aaromalonline/ecometachip/public/simulations_schematics/output_stages(thick)-axeslabeled.png

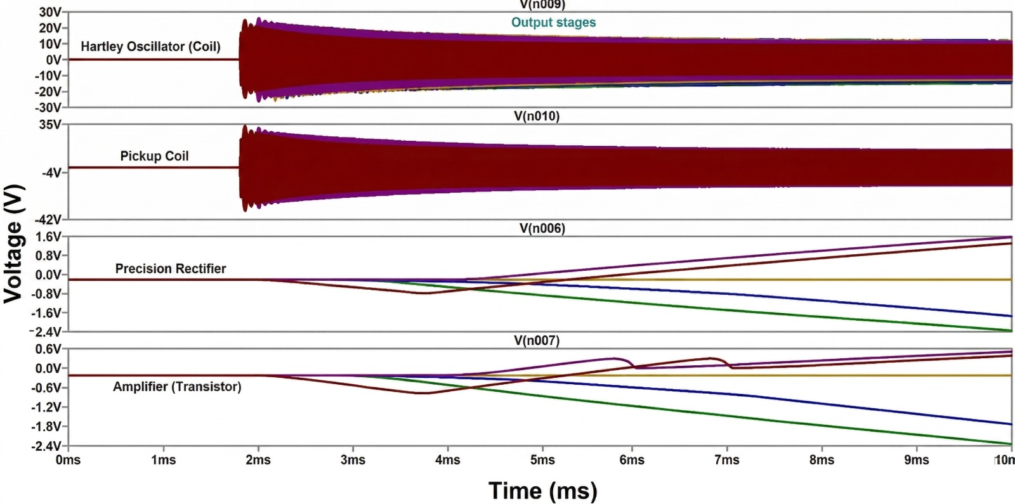
public/simulations_schematics/output_stages(thick)-axeslabeled.png
