aaromalonline/ecometachip/public/exp_setup/torroid-osc(oldckt).jpeg

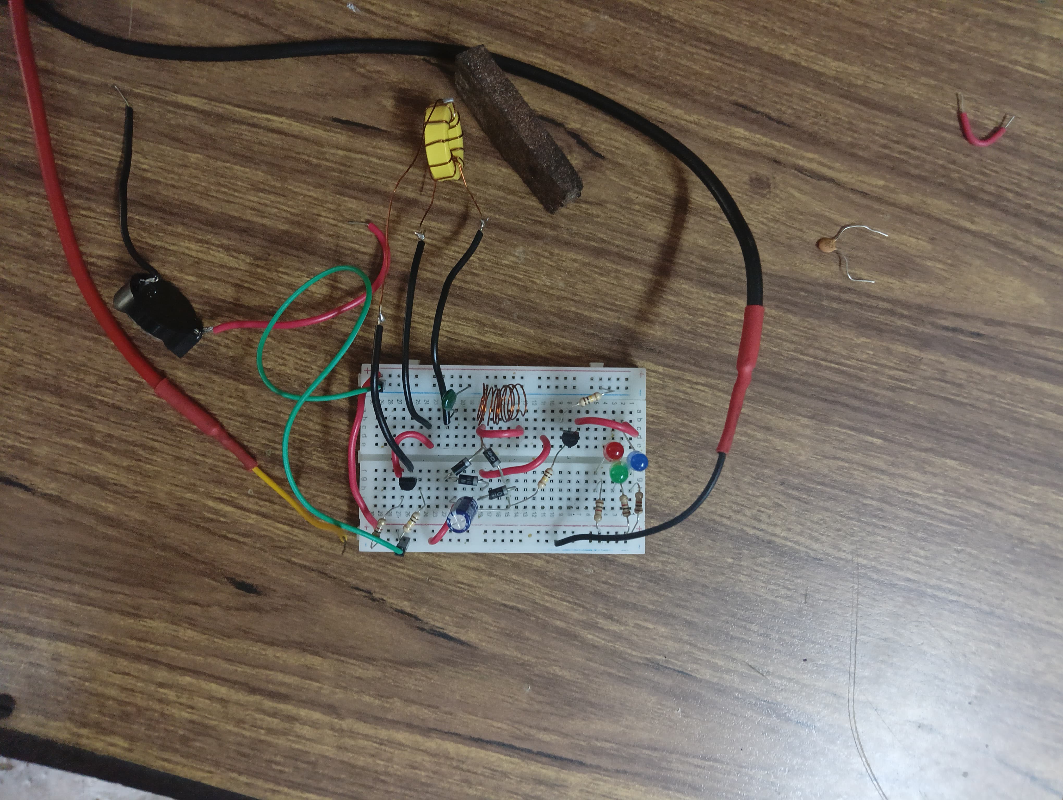
public/exp_setup/torroid-osc(oldckt).jpeg
