aaromalonline/ecometachip/papers/jpaper-main.tex

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

\begin{document}

% --- Title and Authors ---
\begin{center}
    {\Large\bfseries Ecometachip : A Low-Cost, Eco-Friendly Liquid Chemical Identifier Utilizing a Novel Coir-Rubber Substrate\par}
    \vspace{0.6cm}
    {\normalsize\bfseries Aaromal A, Abhiram B, Devanarayanan C.R, and Ivana Anto Kallookaran*\par}
    \vspace{0.4cm}
    {\small \textit{School of Engineering, Electronics \& Communication Engineering,\\ Cochin University of Science and Technology (CUSAT), Kochi, Kerala, India.}\par}
\end{center}
\vspace{0.6cm}

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

\section{Theoretical Framework and Mathematical Modeling}

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

\begin{figure}[H]
    \centering
    
    \caption{Scanning electron microscopy of (a) CoR and (b) CoRC substrates. The addition of carbon to the base CoR matrix creates the highly porous CoRC micro-structure utilized by the Eco-MetaChip for fluid integration. Image reproduced from Manohar et al. \cite{b1}.}
    \label{fig:sem_image}
\end{figure}

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

\vspace*{30pt}
\section{System Design and Hardware Architecture}

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

\begin{figure}[H]
    \centering
    
    \caption{Physical prototype of the EcometaChip. The image highlights the critical non-contact 2 mm air gap maintained between the hand-wound RF pickup coil and the highly porous Coir-Rubber Patch.}
    \label{fig:hardware_setup}
\end{figure}

\vspace*{6pt}
\subsection{Circuit Implementation and LTSpice Modeling}
Prior to physical deployment, the electronic architecture was mathematically modeled using LTspice. The Hartley oscillator utilizes a 47 pF NPO ceramic capacitor and a hand-wound 15-turn toroidal inductor ($54\text{ nH}$). 

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

\vspace*{12pt}
\section{Experimental Observations and Methodological Rigor}

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

plt.rcParams.update({'font.size': 15})

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

# 3. Perform Linear Regression
slope, intercept, r_value, p_value, std_err = stats.linregress(X, Y)

# 4. Create the Plot
plt.style.use('seaborn-v0_8-whitegrid')
plt.figure(figsize=(10, 7))

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

plt.text(45, 100, stats_text, fontsize=11, bbox=dict(facecolor='white', alpha=0.8, edgecolor='gray'))

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

\vspace*{14pt}
\section{Results and System Validation}

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

\newpage
As algorithmically executed and visually rendered by the Python analysis pipeline (Figure \ref{fig:sensitivity}), the system demonstrated a highly linear response. The calculated Sensitivity Fit was \textbf{2.31 mV/$\epsilon_r$} with an exceptional Coefficient of Determination (\textbf{$R^2$ Score}) of \textbf{0.906}. This provides definitive mathematical evidence that optimizing the CoRC carbon content successfully transitioned the material into a highly predictable, quantitative dielectric resonator.

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

\vspace*{6pt}
\subsection{Environmental Robustness and Repeatability}
For any field-deployable analytical instrument, immunity to environmental fluctuations is paramount. Utilizing the extensive dataset provided in Table \ref{tab:completelog}, the Python pipeline computed the baseline output drift across massive environmental swings.

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

\vspace*{6pt}
\subsection{Waveform Output and Hardware Visual Classification}
The current hardware prototype processes the pre-amplification DC output through a 2N3904 transistor to drive a simple multi-level LED interface. The distinct voltage separations achieved at the precision rectifier---and their respective trigger points for the final amplifier---were successfully simulated in LTspice (Figure \ref{fig:waveforms}) and perfectly align with the hardware behavior.

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

\newpage
In physical operation, the forward voltage drops ($V_f$) of parallel Red, Green, and Blue LEDs serve as an analog voltage discriminator:
\begin{itemize}
    \item A low-$\epsilon_r$ liquid like Petrol (yielding a mean of 72 mV) only weakly biases the base of the driver, dimly illuminating the \textbf{Red LED}.
    \item Ethanol ($\epsilon_r \approx 24$, yielding 184 mV) provides enough current gain to trigger both the \textbf{Red and Green LEDs}.
    \item Water, generating the maximum 262 mV baseline due to its massive $\epsilon_r \approx 80$, successfully triggers the highest-threshold \textbf{Blue LED} alongside Red and Green.
\end{itemize}

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

\newpage
\begin{thebibliography}{00}

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

\bibitem{b8} A. R. Von Hippel, \textit{Dielectrics and Waves}, Wiley, New York, 1954.

\end{thebibliography}

\end{document}
