aaromalonline/ecometachip/presentation/apscon26-prs.pdf

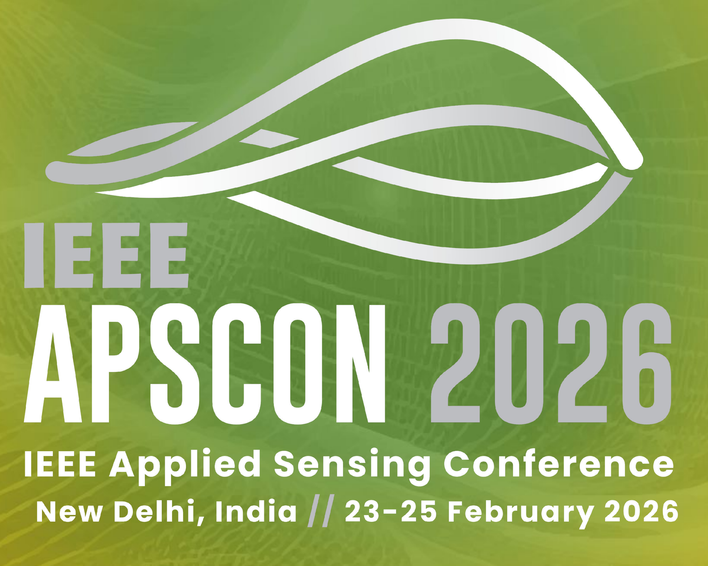
[picture p3: figure]

# Ecometachip-Mini

A Low-Cost, Eco-Friendly Chemical Identifier Utilizing a Novel Coir-Rubber Dielectric Sensor

# Abstract

This paper presents the Eco-MetaChip Mini, a novel, low-cost, and eco-friendly system for the preliminary identification of common liquids based on changes in their relative permittivity (ϵr) using a novel rubber coir material.

Authors : Abhiram B, Aaromal A, Devanarayanan CR, Ivana Anto

Affiliation : School of Engineering, CUSAT (Kerala, India)

# The problem

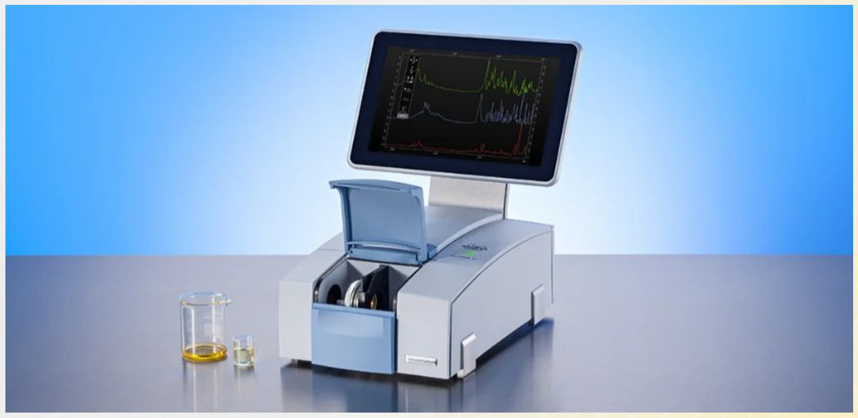
[picture p4: figure]

Need for low-cost, biodegradable sensing for field analysis

Benchtop FT-IR Spectrometers (current)

# Materials Required

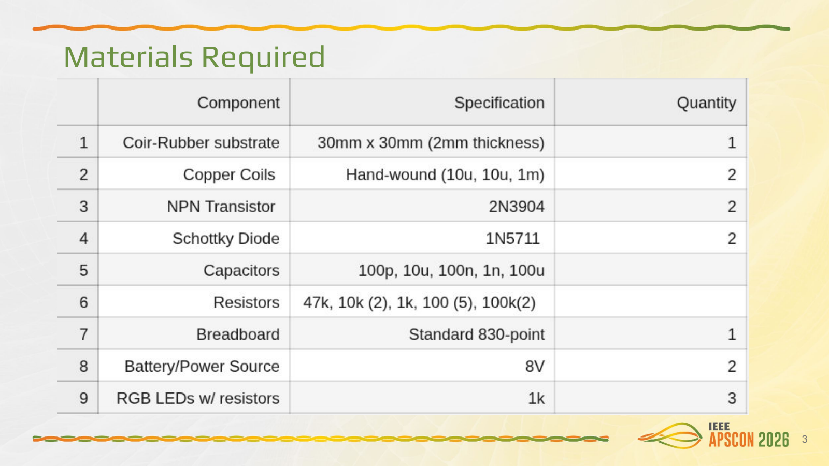
[picture p5: page 4]

# System Architecture

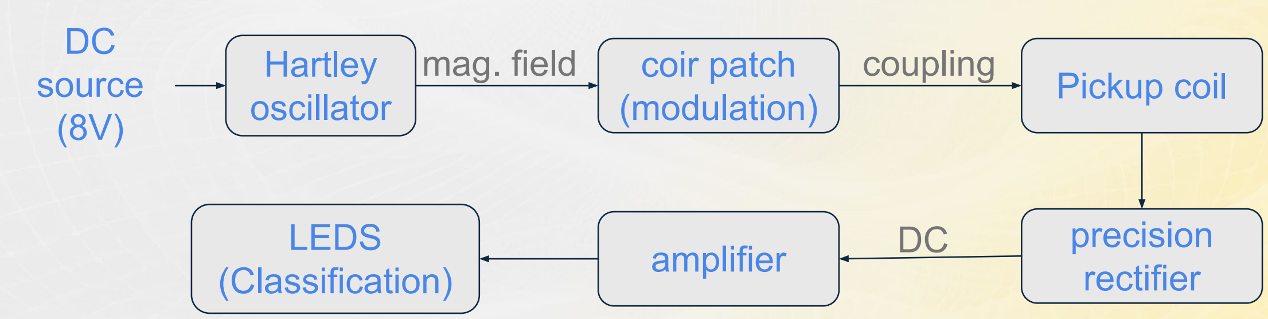
[picture p6: figure]
Hartley oscillator; coir patch; (modulation); Pickup coil; LEDS (Classification); mag. field; coupling; DC source (8V); precision; rectifier amplifier

100 MHz Hartley Oscillator coupled with dielectric resonator

# The Novel Material (Sensing Element)

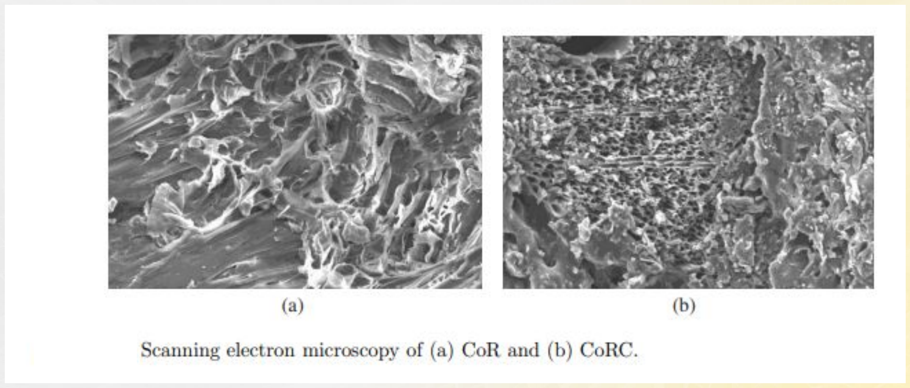
[picture p7: figure]

Coir-Rubber Composite: Porous matrix allows liquid integration

# Methodology/Physics (Dielectric Loading)

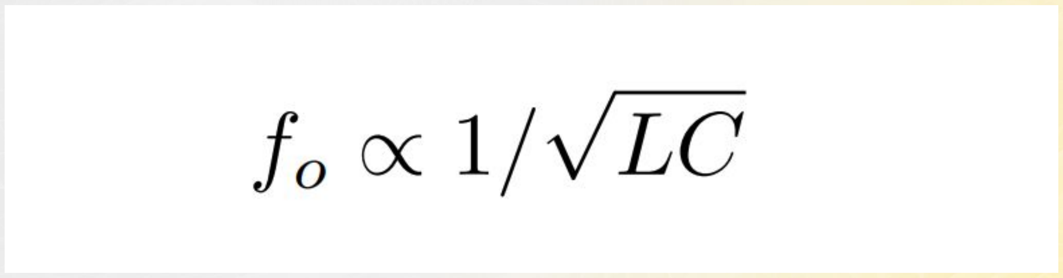
[picture p8: figure]

Liquid permittivity alters capacitance, modulating magnetic field amplitude

# Addressing Signal Loss

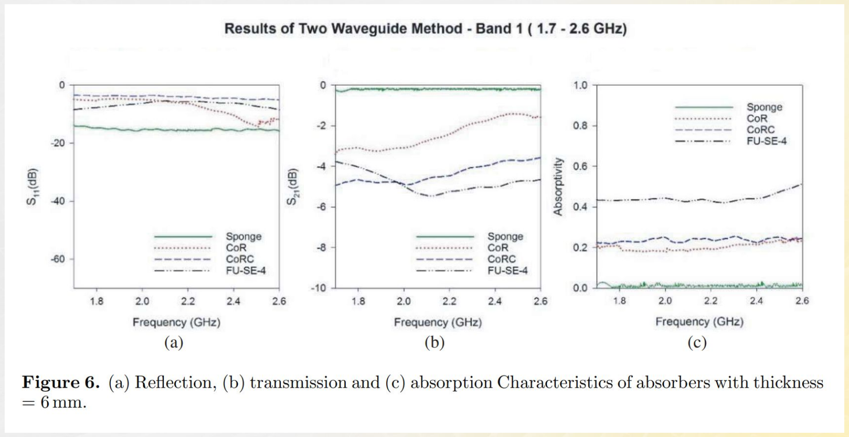
[picture p9: figure]

Carbon content optimized for coupling, not just absorption (εr of rubber-coir substrate with liquid ∝ coupling factor)

# Circuit Implementation

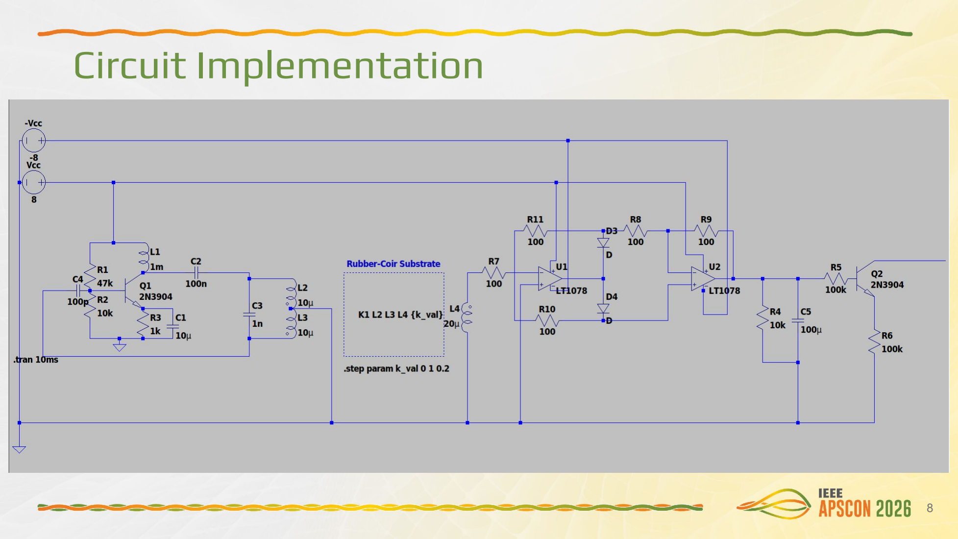
[picture p10: page 9]

## Simulation Results (Coupling)

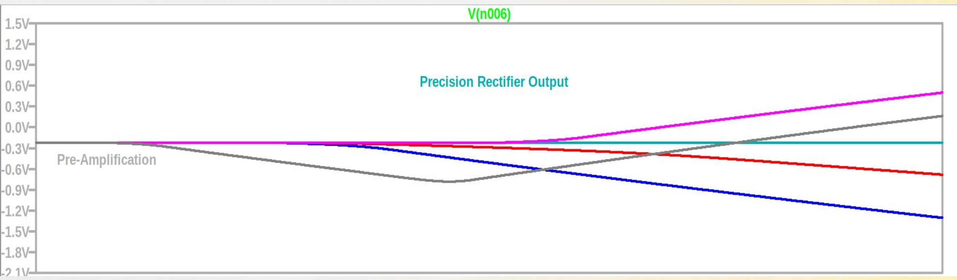
[picture p11: figure]

For increasing k_values btw coils 0, 0.2, 0.4, 0.6 (εr of rubber-coir substrate with liquid ∝ coupling factor k)

# Experimental Observations

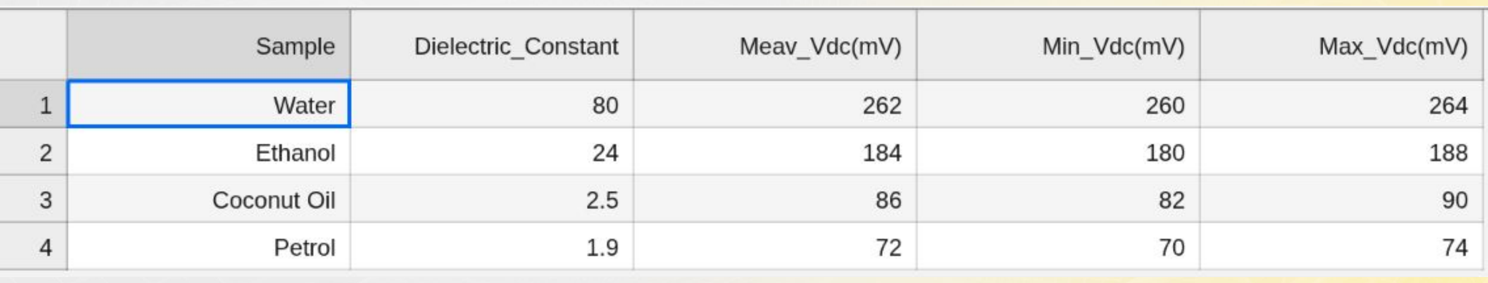
[picture p12: figure]

Higher permittivity liquids generate significantly higher output voltages.

## Repeatability

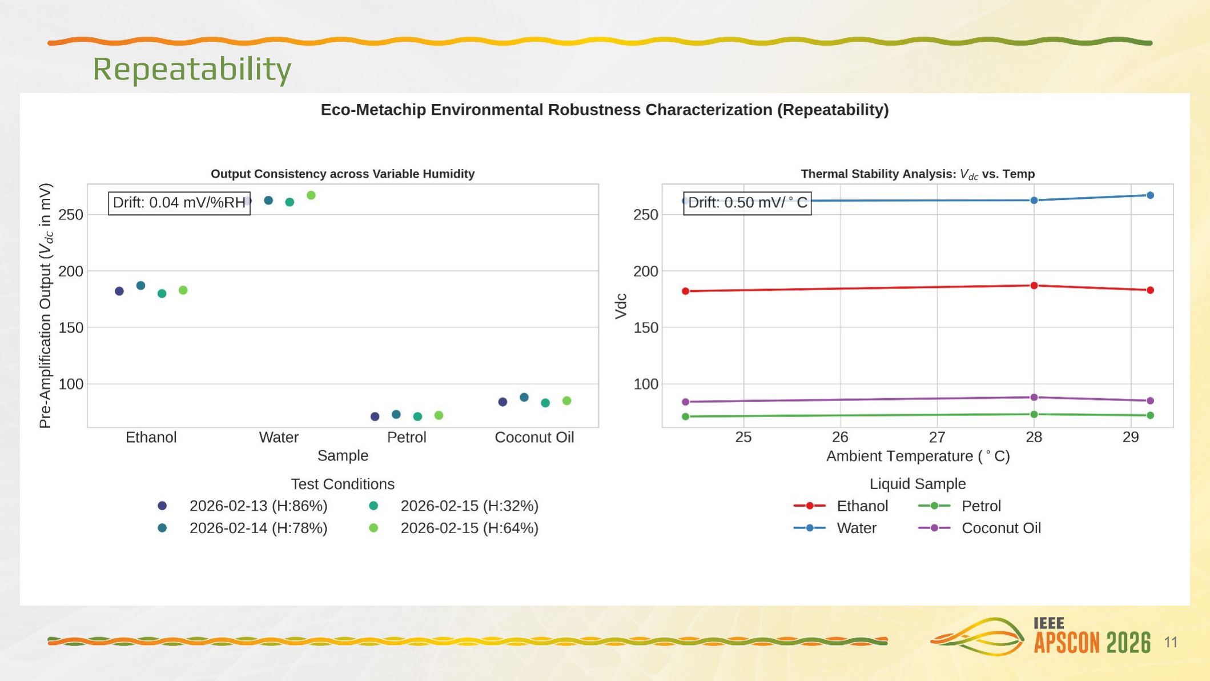
[picture p13: page 12]

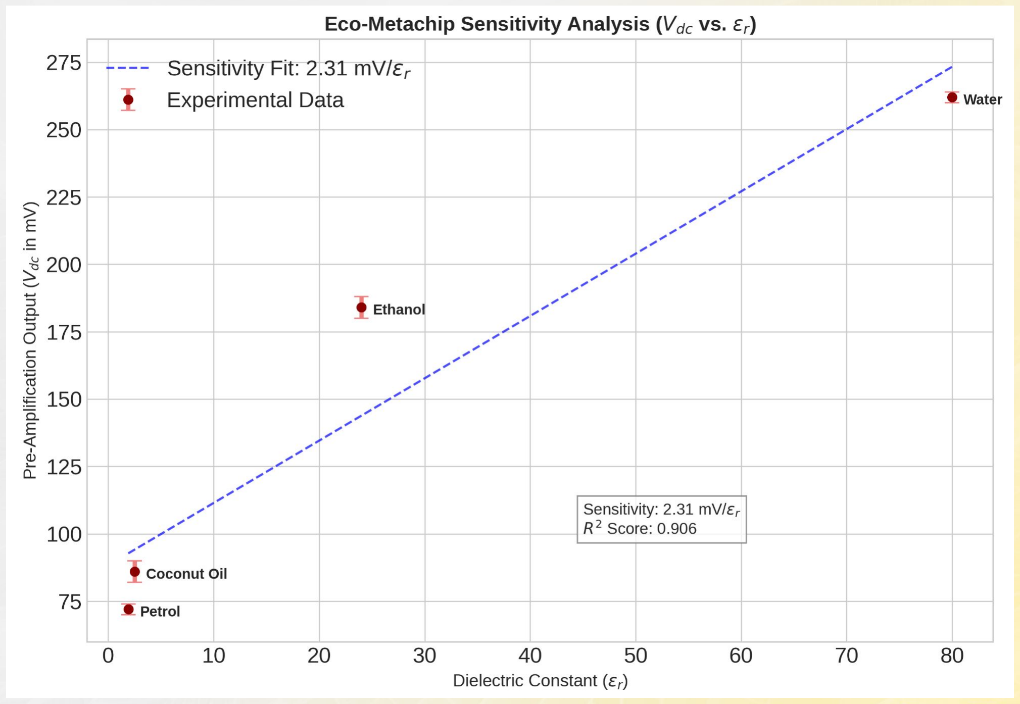
[picture p14: figure]

## Sensitivity

## Exp-Setup & Visual Classification

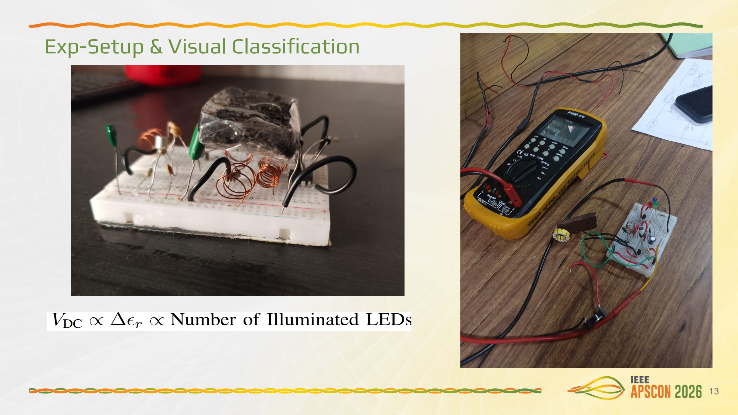
[picture p15: page 14]

# Future : MCU intg. & Digital classification

Op-amp and MCU bridge digitizes analog output for quantitative chemical classification of liquid permittivity.

# Conclusion & References

Eco-friendly, low-power solution for real-time liquid analysis.

Research basis :

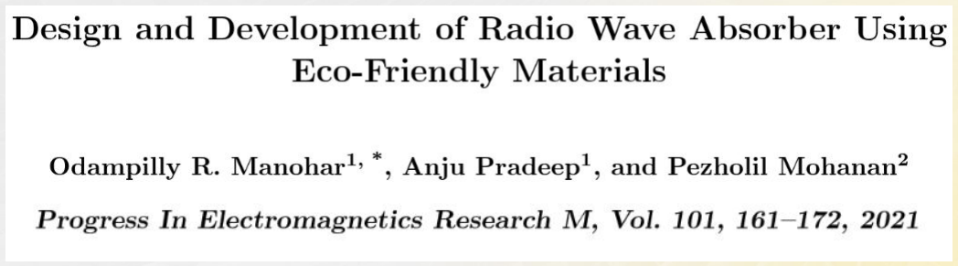
[picture p16: figure]
