aaromalonline/ecometachip/papers/IEEEpaper-ecometachip.pdf

# Eco-Metachip Mini: A Low-Cost, Eco-Friendly Chemical Identifier Utilizing a Novel Coir-Rubber Dielectric Sensor

1

st Aaromal A
School of engineering, Electronics & communication engineering Cochin University of Science & Technology Kochi, India
aaromalanil ec24@ug.cusat.ac.in

2

nd Abhiram B
School of engineering, Electronics & communication engineering Cochin University of Science & Technology Kochi, India
abhiram ec24@ug.cusat.ac.in

3

rd Devanarayanan C.R
School of engineering, Electronics & communication engineering Cochin University of Science & Technology Kochi, India
devanarayanancr ec24@ug.cusat.ac.in

4

th Ivana Anto Kallookaran
School of engineering, Electronics & communication engineering Cochin University of Science & Technology Kochi, India
ivanaanto ec24@ug.cusat.ac.in

Abstract—This paper presents the Eco-MetaChip Mini, a novel, low-cost, and eco-friendly system for the preliminary identification of common liquids (water, ethanol, acetone, and petrol) based on changes in their relative permittivity (ϵr). The core sensing element is a flexible, biodegradable coir-rubber composite patch, an innovative material developed by Prof. Dr. Anju Pradeep and her colleagues at the School of Engineering, CUSAT. This patch is integrated into a non-contact, high-frequency (approximately 100 MHz) Hartley oscillator circuit, where it acts as a coupled secondary resonator. The presence of a liquid droplet on the patch significantly alters its effective dielectric constant, causing a corresponding change in the coupled magnetic field amplitude. This amplitude fluctuation is detected by a pickup coil, rectified, filtered, and then amplified to drive a visual output system using red, green, and blue LEDs. The system successfully demonstrates clear and distinct cutoff voltage responses for liquids with significantly varying dielectric constants, establishing a fast, resource-constrained, and sustainable approach to chemical sensing.

Index Terms—Dielectric sensor, Hartley oscillator, Coir-rubber composite, relative permittivity sensing, Eco-friendly sensor, Chemical identification.

I. INTRODUCTION

The rapid and cost-effective identification of common liquids is crucial across various fields, including environmental monitoring, industrial quality control, and educational laboratories. Traditional methods often rely on spectroscopic or chromatographic techniques, which require expensive instrumentation, complex sample preparation, and specialized training. Addressing the need for simplified, sustainable, and accessible sensing solutions, this work introduces the Eco-MetaChip Mini, a low-cost dielectric-based chemical identifier. The underlying principle of this sensor is the relationship between a liquid’s relative permittivity ϵr and its effect on a high-frequency electromagnetic field. By utilizing an oscillating circuit that is magnetically coupled to a highly sensitive dielectric substrate, changes in the ϵr due to liquid application can be quickly translated into a measurable electrical signal. The novelty of the Eco-MetaChip Mini lies in its integration of an eco-friendly coir-rubber composite patch as the foundational sensing element. This material, composed of coconut fibers and recycled rubber, offers superior flexibility, biodegradability, and has demonstrated unique frequency-

TABLE I
PREDICTED LIQUID BEHAVIOR AND RESPONSE
Liquid | ϵr | ∆f | LED Response
Water | ≈80 | Large | Bright Blue (High)
Ethanol | ≈24 | Medium | Medium Green
Acetone | ≈21 | Small | Dim Red (Low)
Petrol/ Hexane | ≈1.9 | Minimal | No LED / Dim Red

selective absorption properties in the microwave regime, as detailed in Indian Patent No. 489405 [1].
This paper is structured as follows: Section II details the design and theoretical principles of the dielectric sensing mechanism and the Hartley oscillator. Section III presents the fabrication of the coir-rubber patch and the Eco-MetaChip circuit implementation. Section IV discusses the experimental setup, results for different liquid samples, and the corresponding LED visual response. Finally, Section V concludes the work and suggests future research directions.

II. PRINCIPLES OF OPERATION

A. Dielectric Sensing Mechanism via Coir-Rubber Composite The coir-rubber patch serves as a non-contact, ϵr-sensitive micro-strip resonator. The composite is carefully formulated with 60% coir fiber, 30% nitrile rubber, and 10% carbon-black and Copper (Cu) filler, resulting in a flexible patch with dimensions of 30 mm×30 mm and a thickness of 2 mm. When a liquid drop is placed on its surface, the liquid is absorbed into the pores of the coir material, effectively replacing the air in the volume. This causes a dramatic shift in the effective relative permittivity (ϵr) of the coupled resonator system. The resonant frequency (fo) of the system is inversely proportional to the square root of the inductance (L) and capacitance (C):
fo ∝ 1/

√
LC | (1)

Since the capacitance is largely influenced by the effective dielectric constant of the immediate environment, an increase in ϵr due to a high-permittivity liquid (e.g., water, ϵr ≈ 80) results in an increase in the effective capacitance and a corresponding drop in the resonant frequency.
The change in the magnetic field amplitude ∆BRF coupled to the pickup coil, which is positioned in a non-contact arrangement 2 mm from the patch, is therefore a direct function of the liquid’s ϵr. High-ϵr liquids cause a large frequency shift (∆f), leading to a larger change in the 100 MHz signal amplitude collected by the secondary coil.
B. 100 MHz Hartley Oscillator and Signal Processing
The sensing circuit uses a Hartley oscillator configuration (transistor Q1, 2N3904) and an LC tank formed by a 47 pF NPO ceramic capacitor (C1) and a 15-turn toroidal inductor (L1, 54nH at 100 MHz). The oscillator is biased to operate at an approximate frequency of 100 MHz.

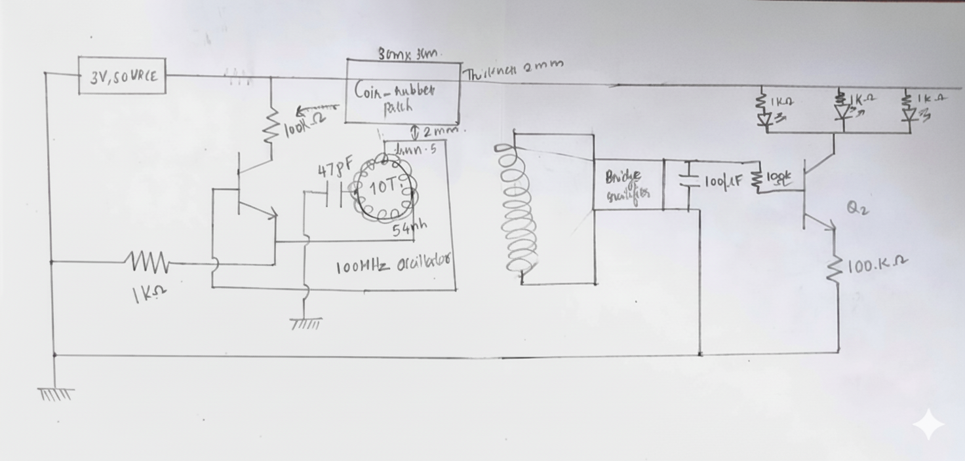
[picture p22: figure]

Fig. 1. Eco-MetaChip Mini Circuit Schematic. The core system consists of a 100 MHz Hartley oscillator (Q1), a non-contact coir-rubber patch, an RF pickup coil, a bridge rectifier stage, and a DC amplification/visual output stage (Q2).

The key signal processing chain is as follows (see Fig. 1 for schematic):
1) RF Pickup: The self-sustained 100 MHz oscillating magnetic field is coupled to the coir-rubber patch. The pickup coil, magnetically coupled to the patch’s near-field, captures an AC signal whose amplitude is modulated by the change in the patch’s ϵr,eff
2) Rectification and Filtering: The captured high-frequency AC signal is converted to a corresponding DC voltage (VDC) using a high-speed 1N4148 silicon diode bridge rectifier (D1–D4). The low junction capacitance (4 pF) and fast recovery time (4 ns) are critical for efficiently handling the RF signal. A 100 µF electrolytic capacitor filters the output, providing a clean DC voltage in the range of 0 mV to 300 mV.
3) Visual Output: The DC voltage is fed to the base of a second NPN transistor (Q2, 2N3904), acting as a current amplifier and driver. Three parallel LEDs (Red, Green, Blue) are connected to the collector of Q2, each with individual current-limiting resistors (1 kΩ). The difference in the forward voltage (Vf ) of the LEDs creates a natural visual bar graph:
- Red LED: Lowest Vf , lights up first.
- Green LED: Medium Vf .
- Blue LED: Highest Vf , only lights up when the VDC is high.

III. MATERIALS AND FABRICATION

A. Coir-Rubber Composite Sensor Patch

The biodegradable sensor patch is fabricated from a novel composite material, leveraging the natural porosity of coconut coir fibers. The precise composition is 60% coir fiber, 30% nitrile rubber, and 10% carbon-black with Copper (Cu) filler, designed to exhibit high sensitivity to liquid absorption while maintaining flexibility and mechanical integrity. The patch is cut to the physical dimensions of 30 mm×30 mm with a uniform thickness of 2 mm. The porous structure allows capillary action to wick the liquid into the material matrix, ensuring a significant, quantifiable change in the effective dielectric

TABLE II
KEY COMPONENT SPECIFICATIONS
Component | Specification
Power Source | 3 V CR2032 cell
Sensing Element | 30 mm×30 mm×2 mm Coir-Rubber Patch
Oscillator Frequency (fo) | ≈100 MHz
Toroidal Inductor (L1) | 15 Turns, 8 mm OD, 54nH
Oscillator Capacitor (C1) | 47 pF NPO Ceramic
Oscillator/Driver (Q1, Q2) | 2N3904 NPN Transistor
Rectifier Diodes (D1–D4) | 1N4148 Silicon Diodes (4 ns recovery)
Filter Capacitor | 100 µF Electrolytic
Output LED Resistors | 1 kΩ (R5, R6, R7)

environment of the coupled system. The material development and its frequency-selective absorption characteristics are based on established work [1].

B. Electronic Circuit Implementation
The complete Eco-MetaChip Mini circuit is powered by a 3 V CR2032 cell and is designed for low power consumption (1–2 mA). The key components and specifications are summarized in Table II.
The 100 MHz Hartley oscillator (Q1, 2N3904) is built around an LC tank comprising a 47 pF NPO ceramic capacitor (C1) and the 15-turn toroidal inductor (L1). The toroidal core ferrite (High Frequency) ensures efficient magnetic field generation. The base of Q1 is biased via a 100 kΩ resistor. The RF pickup coil, consisting of two short wire turns, is positioned 2 mm above the coir-rubber patch. This non-contact arrangement ensures maximum coupling efficiency to the patch’s near-field while maintaining the sanitary integrity of the circuit board.
The RF signal captured by the pickup coil is immediately rectified by a 1N4148 diode bridge, chosen for its 4 ns recovery time, which is essential for RF signal conversion. The resulting DC signal is smoothed by a 100 µF electrolytic capacitor, producing the VDC output for the visual stage. The final stage uses Q2 (2N3904) to drive the visual output. The collector of Q2 is connected to three parallel LEDs (Red, Green, Blue) through individual 1 kΩ limiting resistors (R5, R6, R7). The amplifier configuration ensures that small changes in VDC (base input) translate to distinct changes in the current across the LEDs (collector load).

IV. EXPERIMENTAL RESULTS AND DISCUSSION
A. Experimental Setup
The Eco-MetaChip Mini prototype was tested with 50 µL droplets of four distinct liquid samples: deionized water, absolute ethanol, acetone, and standard unleaded petrol. The VDC output voltage at the bridge rectifier stage was monitored using a digital multimeter, and the resulting visual LED states were recorded. The ambient temperature was maintained at 25◦C. The experimental setup is illustrated in Fig. 2.
B. ϵr-Dependent Output Voltage Response
The results, summarized in Table III, demonstrate a clear correlation between the liquid’s relative permittivity (ϵr) and the measured DC output voltage (VDC).

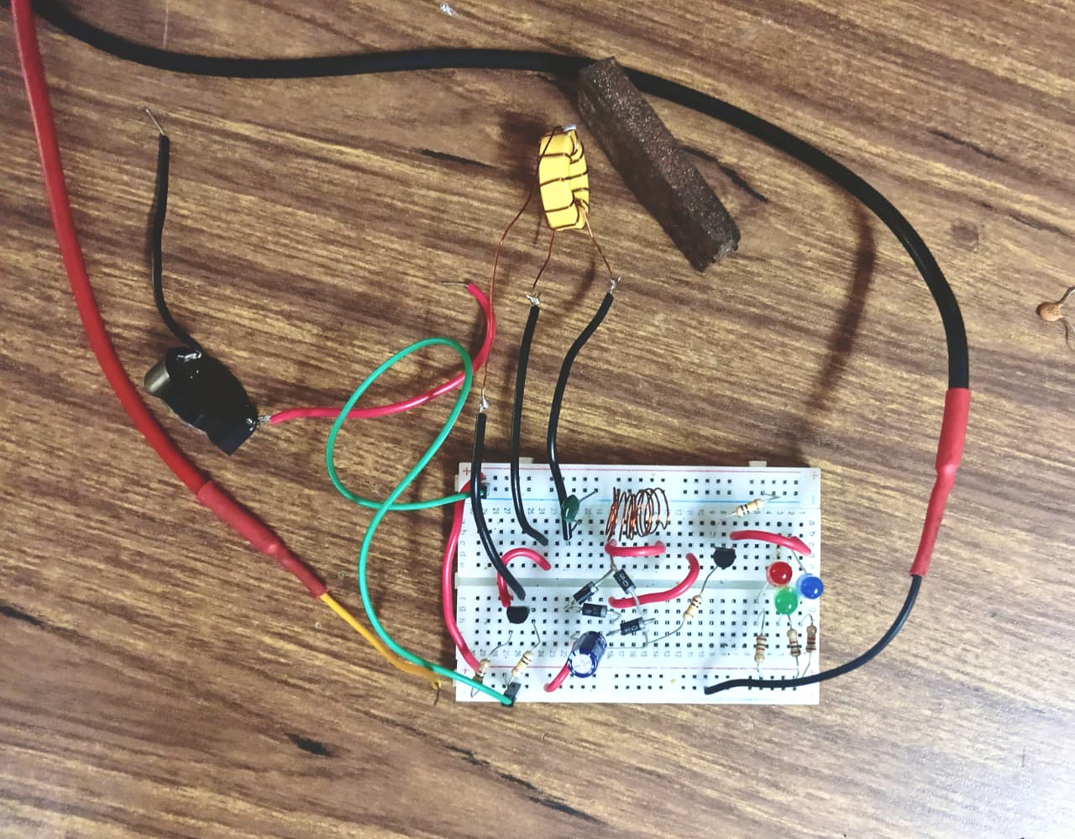
[picture p23: figure]

Fig. 2. Experimental Setup. The non-contact 2 mm air gap between the RF pickup coil and the Coir-Rubber Patch. The test liquid is dispensed onto the center of the patch, and the resulting VDC output is measured before the Q2 driver stage.

TABLE III
MEASURED VDC AND VISUAL OUTPUT
Liquid Sample | Approx. ϵr | Measured VDC (mV) | Observed LED State
Air (Baseline) | 1.0 | 45 mV | None
Petrol (≈ Hexane) | ≈1.9 | 70 mV | Very Dim Red
Acetone | ≈21 | 135 mV | Bright Red
Ethanol | ≈24 | 190 mV | Red and Green
Deionized Water | ≈80 | 260 mV | Red, Green, and Blue

When the patch is exposed only to air, the oscillator coupling is minimal, resulting in a low baseline VDC of 45 mV and no illuminated LEDs. Applying petrol (ϵr ≈ 1.9) results in only a slight VDC increase to 70 mV, which is sufficient to weakly forward bias the Red LED.

The application of acetone (ϵr ≈ 21) and ethanol (ϵr ≈
24) causes a moderate frequency shift and a corresponding increase in VDC to 135 mV and 190 mV, respectively. The Red LED lights brightly for acetone, and both the Red and Green LEDs are clearly lit for ethanol. This outcome validates the system’s ability to differentiate between liquids with closely grouped ϵr values.

Finally, water, with the highest ϵr ≈ 80, induces the largest frequency perturbation, resulting in the maximum VDC of 260 mV. This voltage successfully triggers the Blue LED, in addition to the Red and Green, providing a clear visual confirmation of the highest permittivity liquid.

C. LED Cutoff Voltage Analysis
The visual output system functions as a voltage discriminator based on the cumulative forward voltage drop across the parallel LEDs and the required current to achieve visible brightness through the 1 kΩ current-limiting resistors.
The relationship between the VDC input and the LED state provides a distinct three-level classification:

VDC ∝ ∆ϵr ∝ Number of Illuminated LEDs

The results confirm the design principle: the highest ϵr liquid (water) generates the highest VDC signal, successfully clearing the cutoff for the Blue LED, while low-ϵr liquids (petrol, acetone) only clear the cutoff for the Red LED.

V. CONCLUSION AND FUTURE WORK The Eco-MetaChip Mini successfully demonstrates a low-cost, eco-friendly approach to chemical identification utilizing a novel coir-rubber composite patch as a dielectric sensor. By integrating this sustainable material with a simple 100 MHz Hartley oscillator and a visually intuitive LED output, the system provides a clear, three-level classification (Red, Green, Blue) of common liquids based on their relative permittivity (ϵr). The distinct VDC levels generated for water, ethanol, and acetone validate the efficacy of the magnetic-field coupling and the dielectric sensing principle. Future work will focus on integrating a digital output stage for quantitative ϵr measurement, developing self-calibration methods to compensate for environmental factors, and testing the system’s longevity and repeatability in real-world scenarios.

ACKNOWLEDGMENT
The authors gratefully acknowledge the foundational work on the coir-rubber composite patch by Prof. Dr. Anju Pradeep and her research group at the School of Engineering, Cochin University of Science and Technology (CUSAT).

REFERENCES

[1] Prof. Dr. Anju Pradeep, et al., ”Frequency Selective Absorber using an Innovative Arrangement of Coir and Rubber,” Indian Patent No. 489405, granted 2022.
[2] R. D. Lide, Ed., CRC Handbook of Chemistry and Physics, 89th ed. Boca Raton, FL: CRC Press, 2008.
[3] M. Young, The Technical Writer’s Handbook. Mill Valley, CA: University Science, 1989.
