aaromalonline/ecometachip/presentation/apscon26-pres_cert.jpg

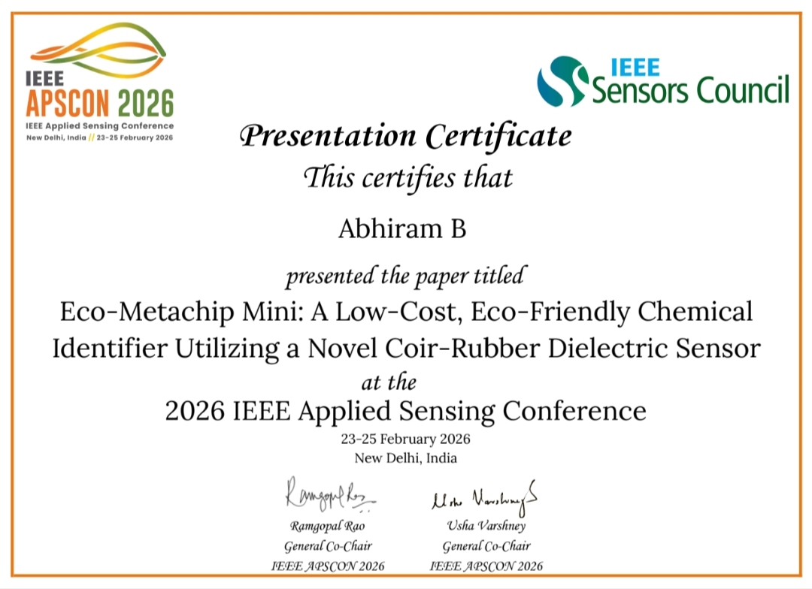
presentation/apscon26-pres_cert.jpg
