aaromalonline/ecometachip/public/simulations_schematics/bridgerect/k_0.5(BvAcoupling).png

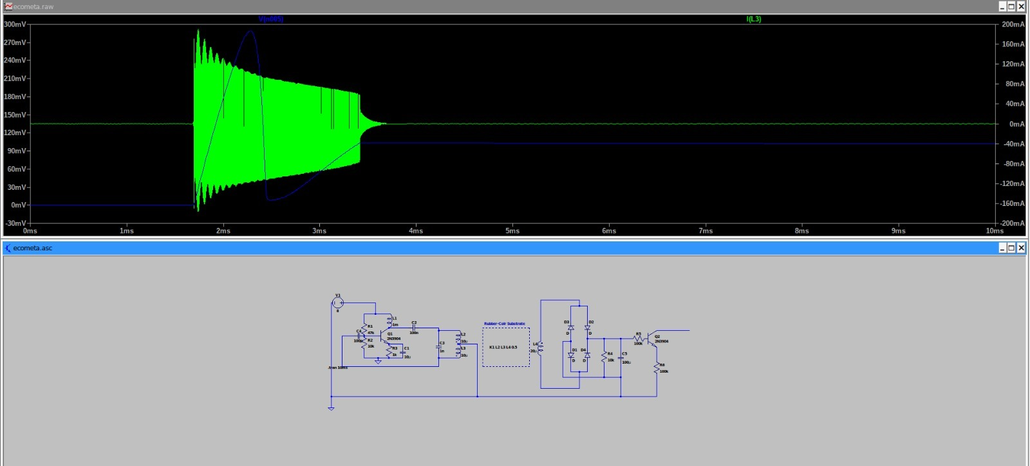
public/simulations_schematics/bridgerect/k_0.5(BvAcoupling).png
