aaromalonline/ecometachip/public/simulations_schematics/bridgerect/k_0.5.png

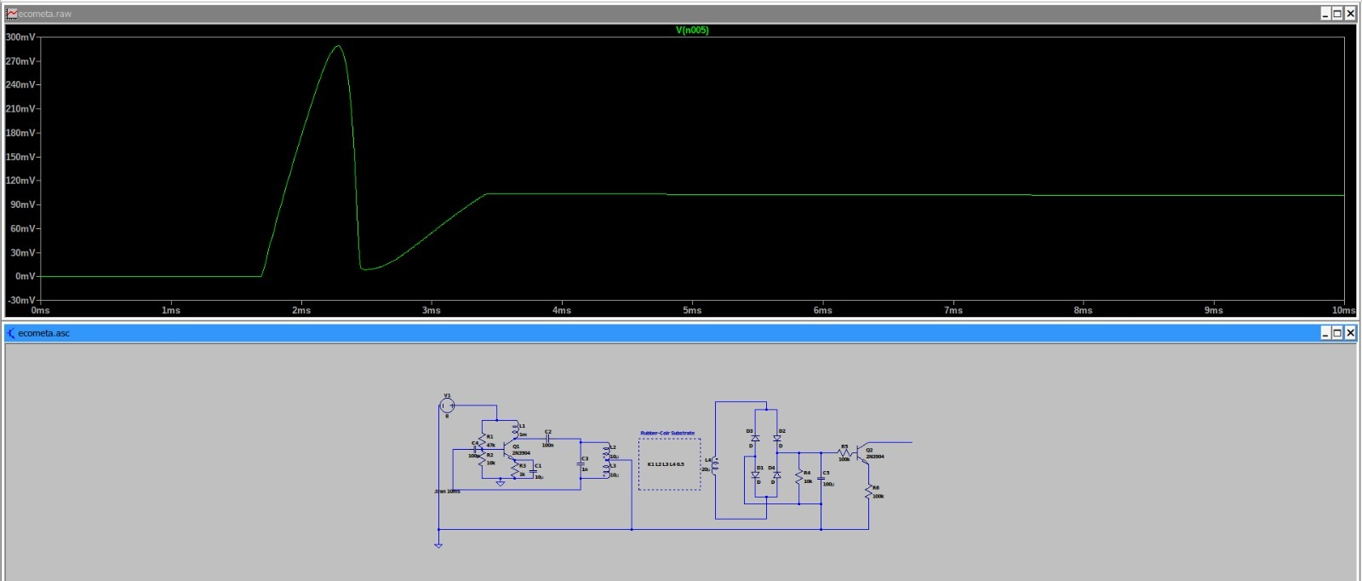
public/simulations_schematics/bridgerect/k_0.5.png
