aaromalonline/ecometachip/public/simulations_schematics/bridgerect/k_0.png

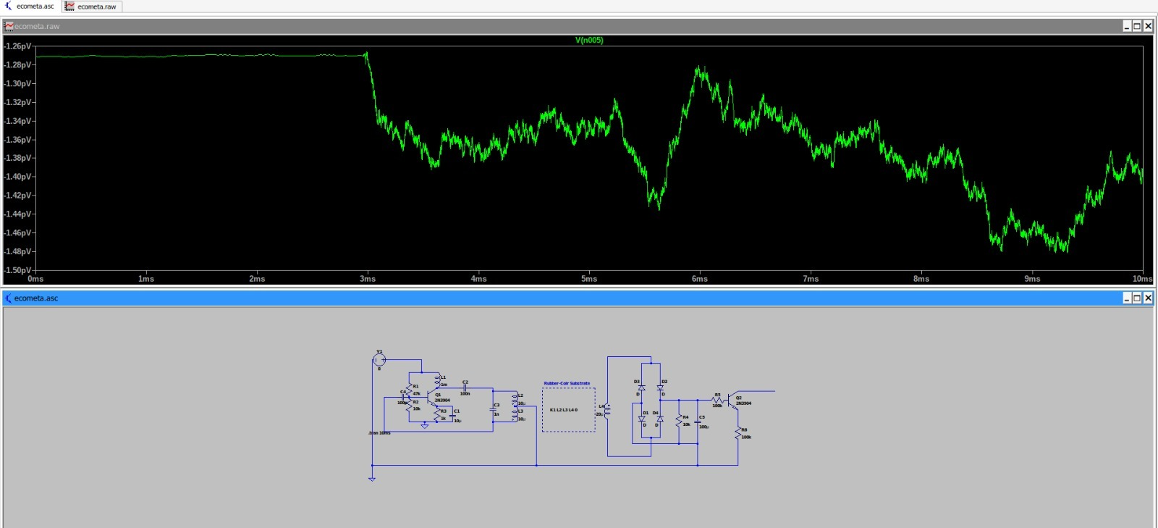
public/simulations_schematics/bridgerect/k_0.png
