aaromalonline/ecometachip/public/simulations_schematics/bridgerect/k_1.png

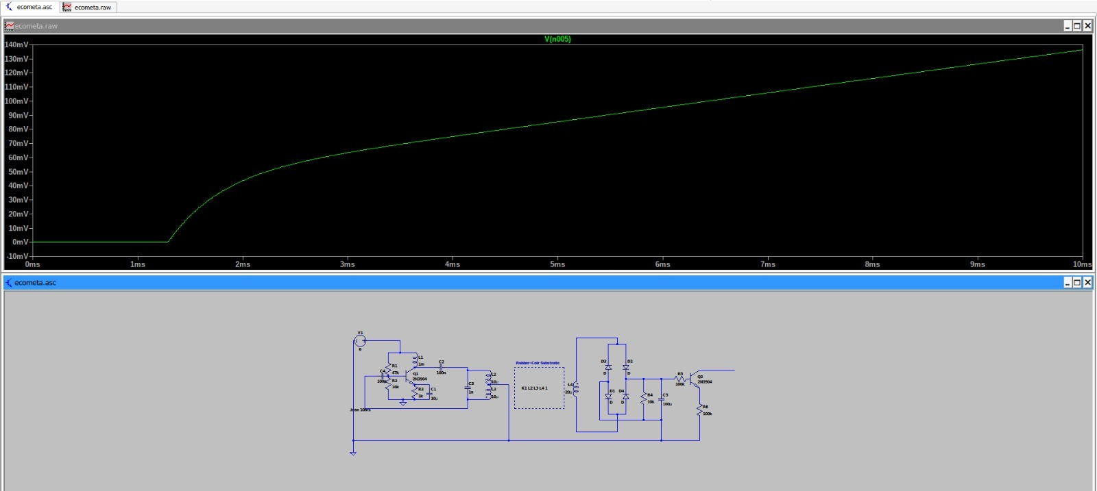
public/simulations_schematics/bridgerect/k_1.png
