aaromalonline/ecometachip/public/simulations_schematics/bridgerect/stepk_out.png

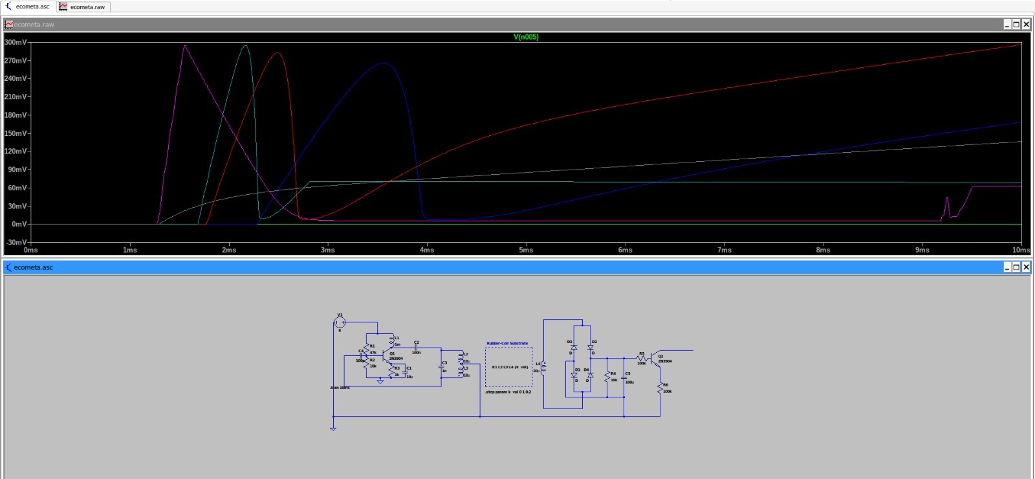
public/simulations_schematics/bridgerect/stepk_out.png
