aaromalonline/ecometachip/public/simulations_schematics/output_stages(thick).png

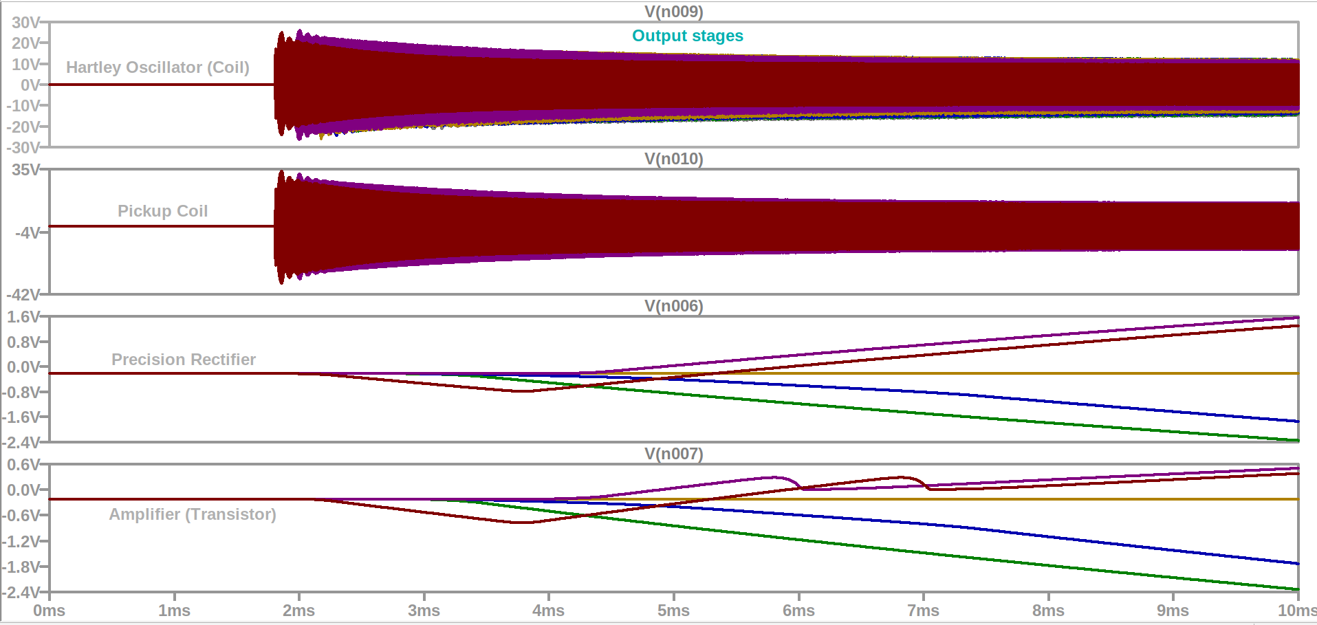
public/simulations_schematics/output_stages(thick).png
