aaromalonline/ecometachip/public/simulations_schematics/output_stages.png

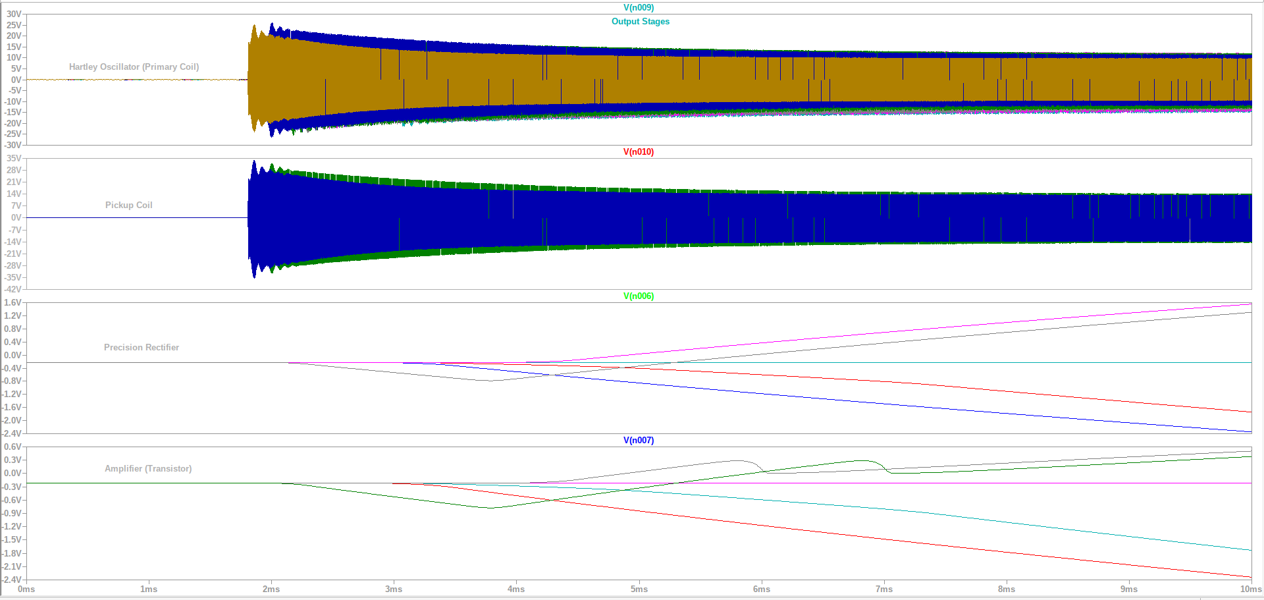
public/simulations_schematics/output_stages.png
