aaromalonline/ecometachip/public/simulations_schematics/rect_out.png

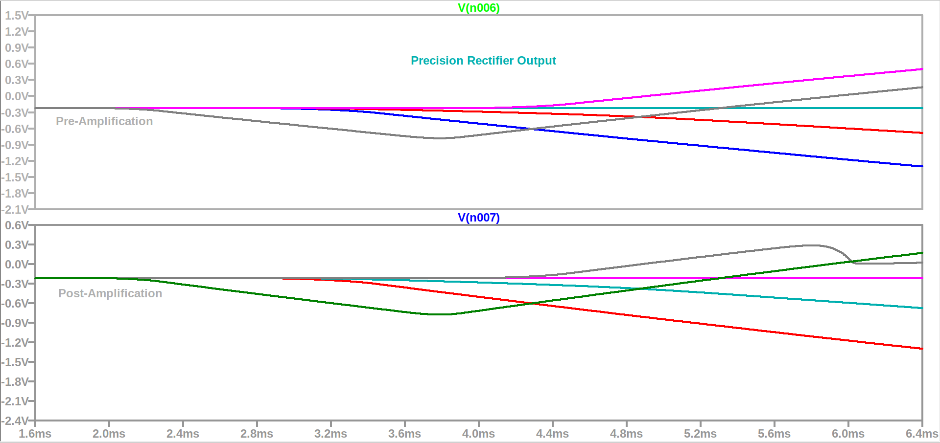
public/simulations_schematics/rect_out.png
