aaromalonline/ecometachip/public/exp_setup/newckt1.jpeg

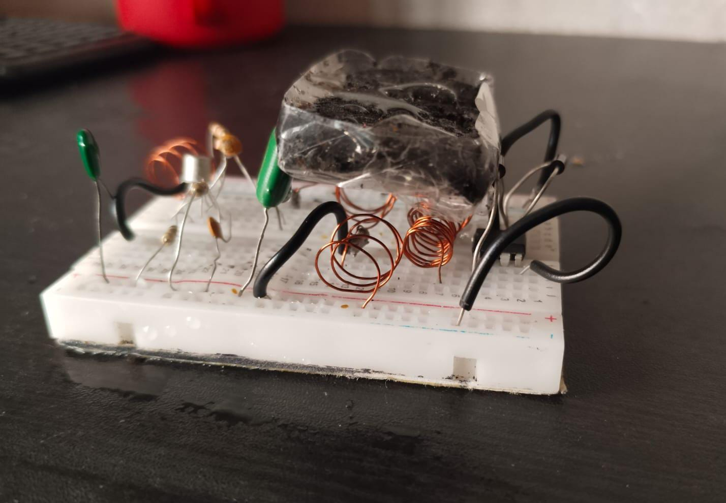
public/exp_setup/newckt1.jpeg
