aaromalonline/ecometachip/public/exp_setup/newckt2.jpeg

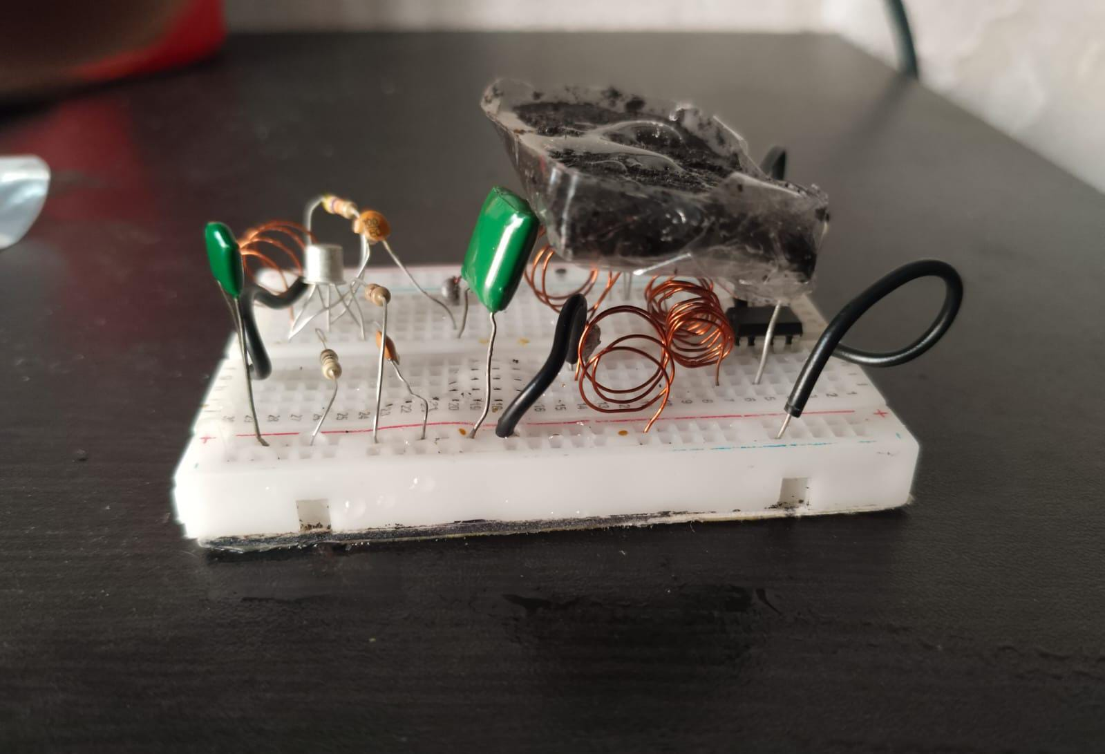
public/exp_setup/newckt2.jpeg
