aaromalonline/ecometachip/public/simulations_schematics/ecometa.asc

-Vcc: voltage; -8
C1: cap; 10µ
C2: cap; 100n
C3: cap; 1n
C4: cap; 100p
C5: cap; 100µ
D3: diode
D4: diode
L1: ind; 1m; Rser=1m
L2: ind; 10µ; Rser=1m
L3: ind; 10µ; Rser=1m
L4: ind; 20µ; Rser=1m
Q1: npn; 2N3904
Q2: npn; 2N3904
R1: res; 47k
R2: res; 10k
R3: res; 1k
R4: res; 10k
R5: res; 100k
R6: res; 100k
R7: res; 100
R8: res; 100
R9: res; 100
R10: res; 100
R11: res; 100
U1: LT1078
U2: LT1078
Vcc: voltage; 8
Named nets: 0
.tran 10ms
K1 L2 L3 L4 {k_val}
Rubber-Coir Substrate
.step param k_val 0 1 0.2
