aaromalonline/ecometachip/(commit log)

2026-02-19 Organized project structure and added gitignore for sims&venv
    [complete_preampobslog.csv, general_preampobs.csv]
2026-02-20 materials req added
    [matreq.csv]
2026-02-20 Enhance speaker notes with detailed explanations
    Added detailed explanations about the R^2 value, uncertainty in readings, and the relationship between dielectric constant and voltage output.
2026-02-20 Update Slide 8 title to include 'Coupling vs Absorption'
2026-02-21 coupling-permitivity physical significance csv added
    [kperm_physig.csv]
